paulovjt1-create/Color_Selection_Robot/Pictures/Assembly.jpeg

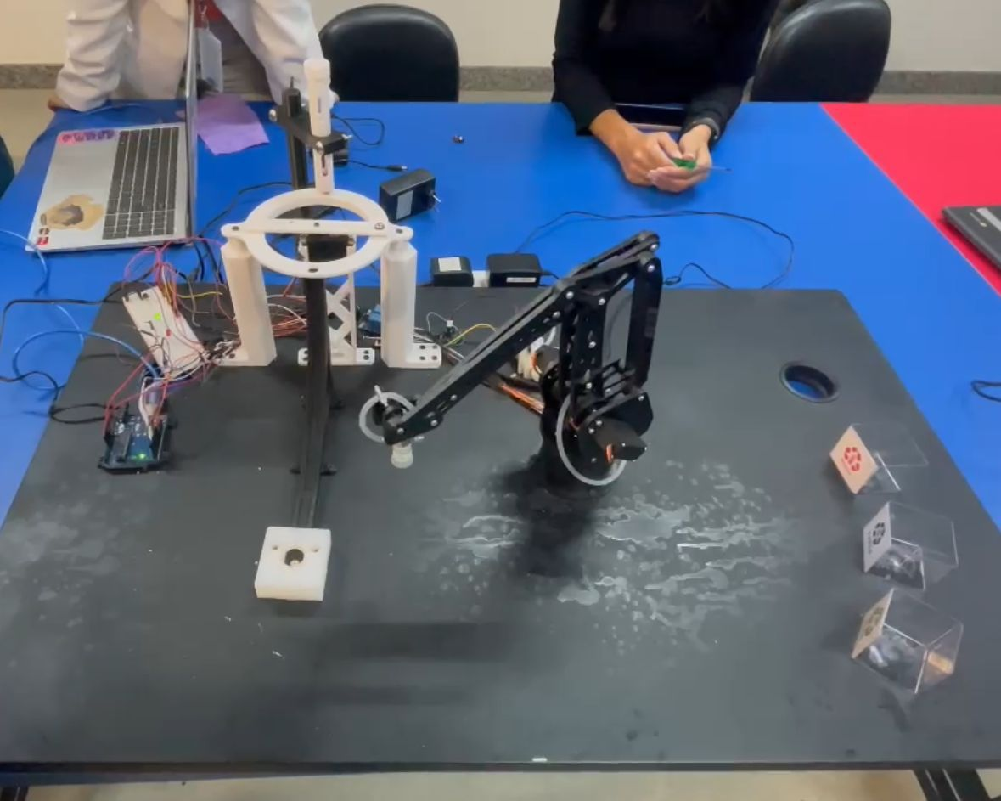
Pictures/Assembly.jpeg
