paulovjt1-create/Color_Selection_Robot/Pictures/3D Robot.jpeg

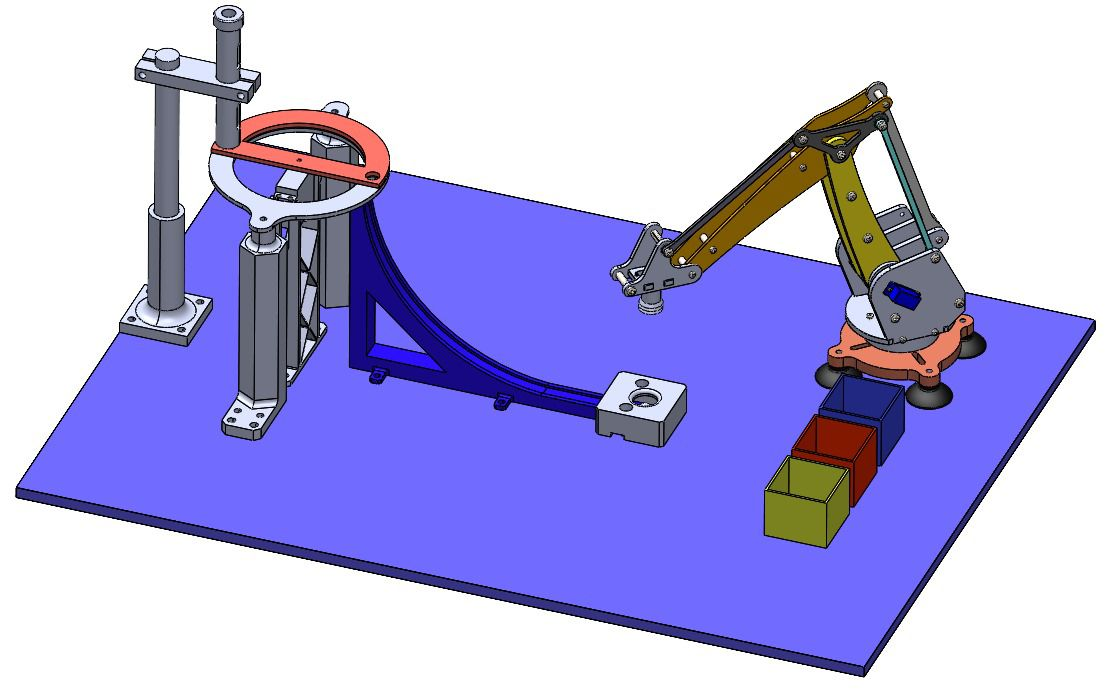
Pictures/3D Robot.jpeg
