paulovjt1-create/Color_Selection_Robot/Project Design/TUBO.STEP

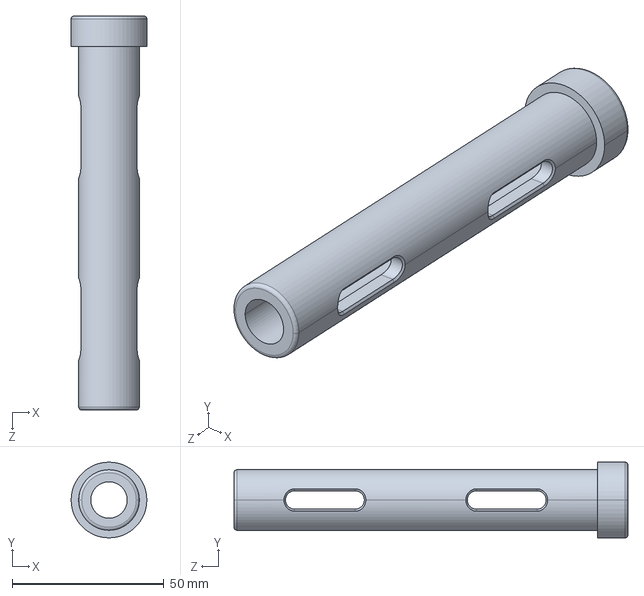
[picture p9: CAD file, 2025-09-03]
Project Design/TUBO.STEP
25.0 x 25.0 x 130.0 mm
