paulovjt1-create/Color_Selection_Robot/Project Design/SUPORTE TUBO BASE.STEP

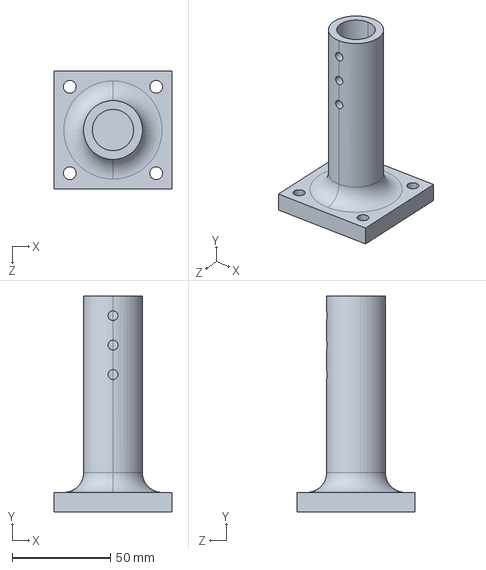
[picture p10: CAD file, 2025-09-03]
Project Design/SUPORTE TUBO BASE.STEP
60.0 x 110.0 x 60.0 mm
