paulovjt1-create/Color_Selection_Robot/Project Design/DISCO MÓVEL.STEP

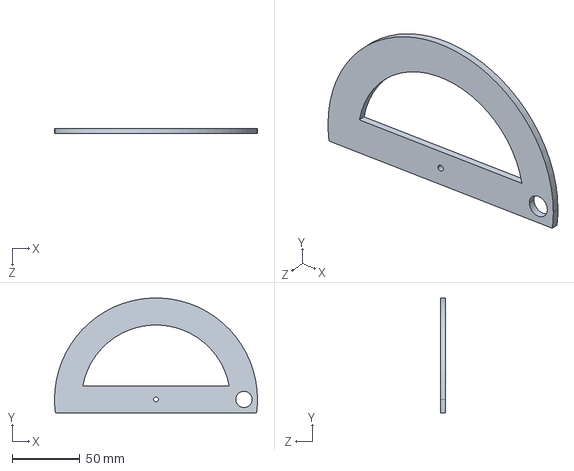
[picture p11: CAD file, 2025-09-03]
Project Design/DISCO MÓVEL.STEP
150.0 x 84.9 x 4.00 mm
