paulovjt1-create/Color_Selection_Robot/Project Design/MONTAGEM v3.step

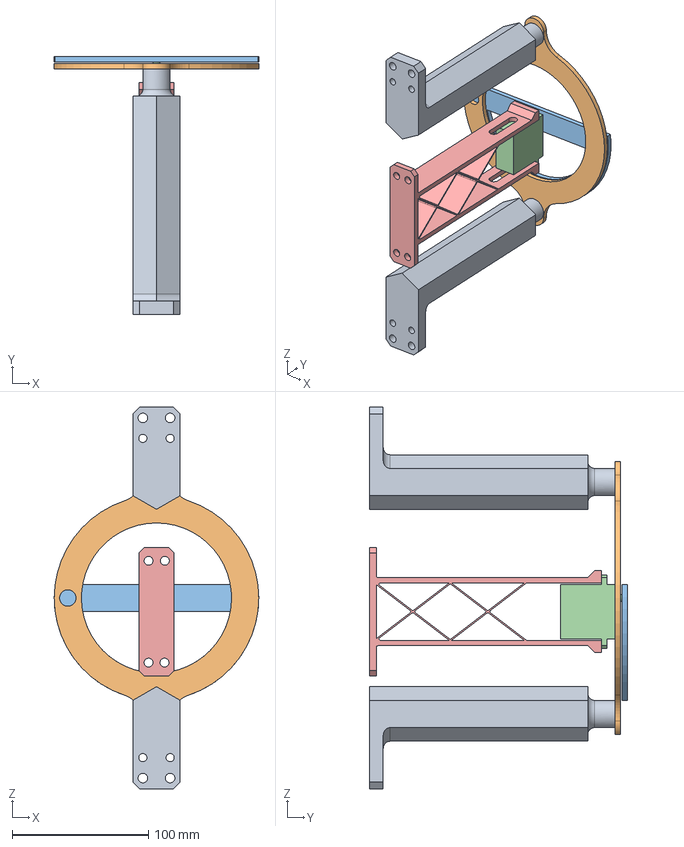
[picture p12: CAD file, 2025-09-03]
Project Design/MONTAGEM v3.step
150.0 x 189.0 x 280.0 mm
TORRE x 2
DISCO FIXO.step
DISCO MÓVEL.step
SERVOMOTOR
