paulovjt1-create/Color_Selection_Robot/Project Design/RAMPA.STEP

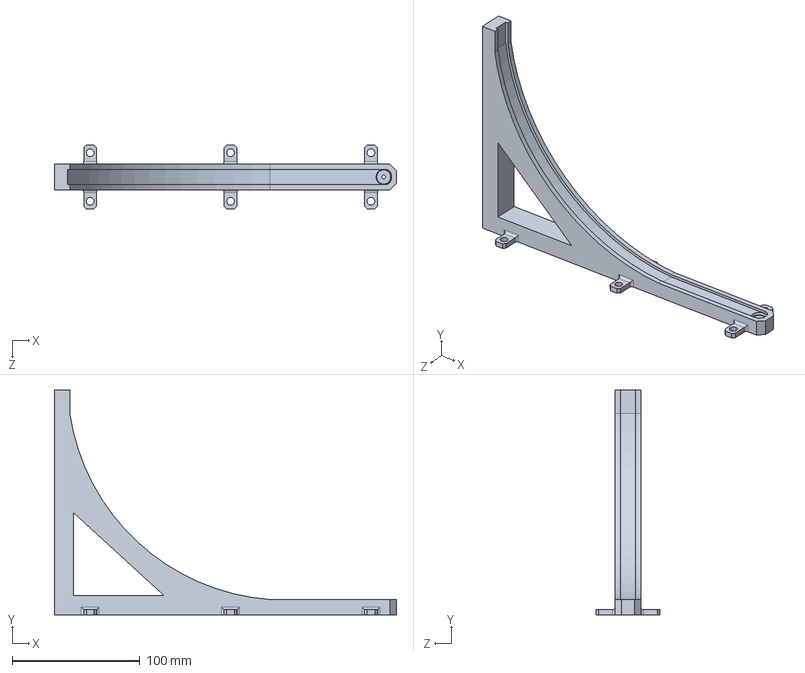
[picture p13: CAD file, 2025-09-03]
Project Design/RAMPA.STEP
267.9 x 176.0 x 50.0 mm
