paulovjt1-create/Color_Selection_Robot/Project Design/DISCO FIXO.STEP

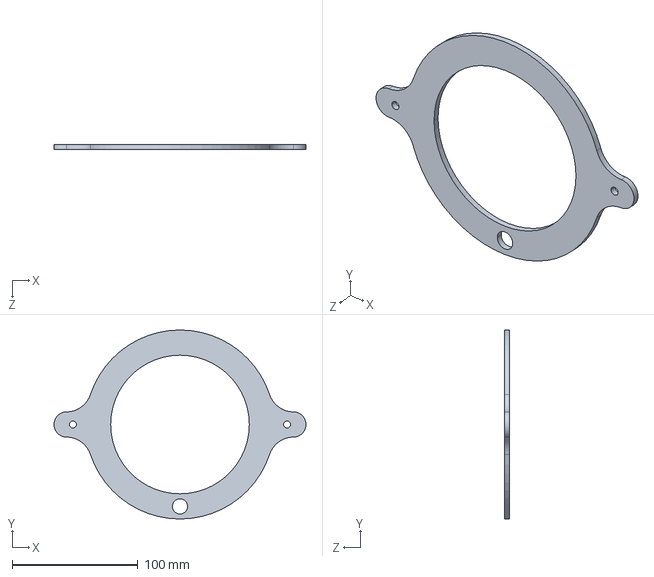
[picture p14: CAD file, 2025-09-03]
Project Design/DISCO FIXO.STEP
200.0 x 150.0 x 4.00 mm
