paulovjt1-create/Color_Selection_Robot/Project Design/TORRE.STEP

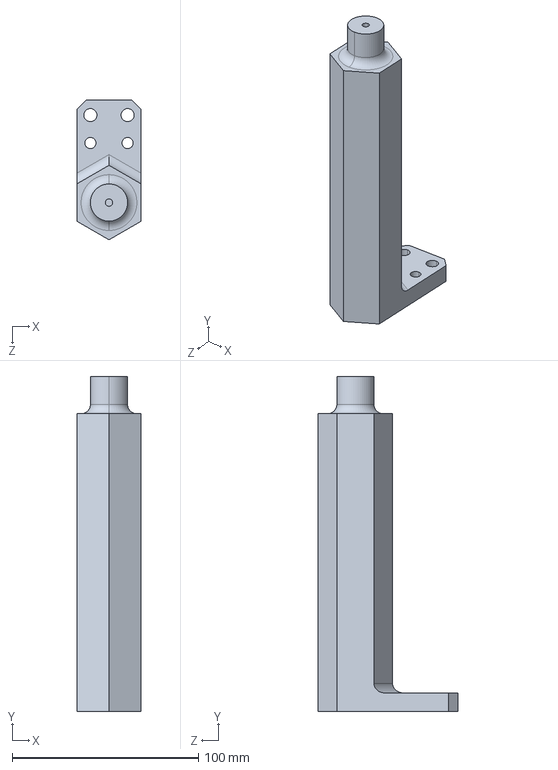
[picture p15: CAD file, 2025-09-03]
Project Design/TORRE.STEP
34.6 x 180.0 x 75.0 mm
