paulovjt1-create/Color_Selection_Robot/Project Design/SUPORTE MOTOR CENTRAL  v2.step

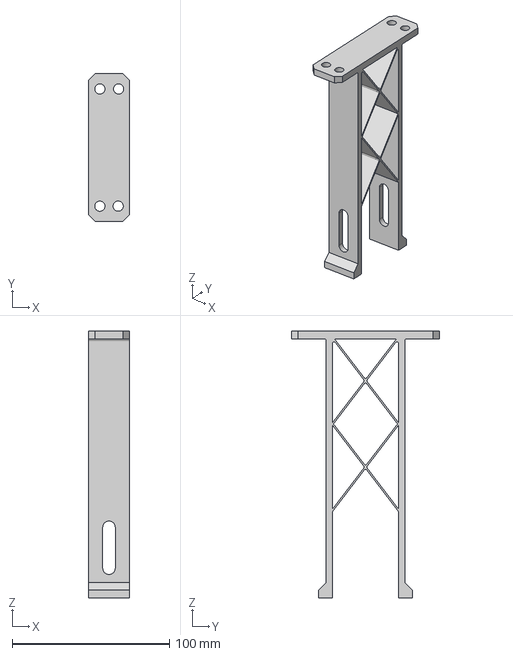
[picture p16: CAD file, 2025-09-03]
Project Design/SUPORTE MOTOR CENTRAL v2.step
26.0 x 94.0 x 170.0 mm
